BTbricks/modular-bluetooth-receiver/Modular Remote Control Receiver/board/modular-bluetooth-receiver-brd.png

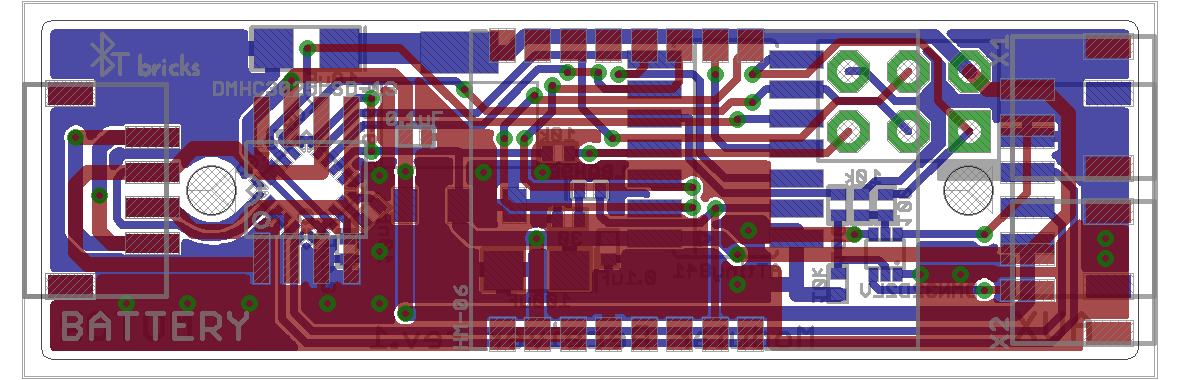
Modular Remote Control Receiver/board/modular-bluetooth-receiver-brd.png
