BTbricks/modular-bluetooth-receiver/Modular Remote Control Receiver/board/modular-bluetooth-receiver-sch.png

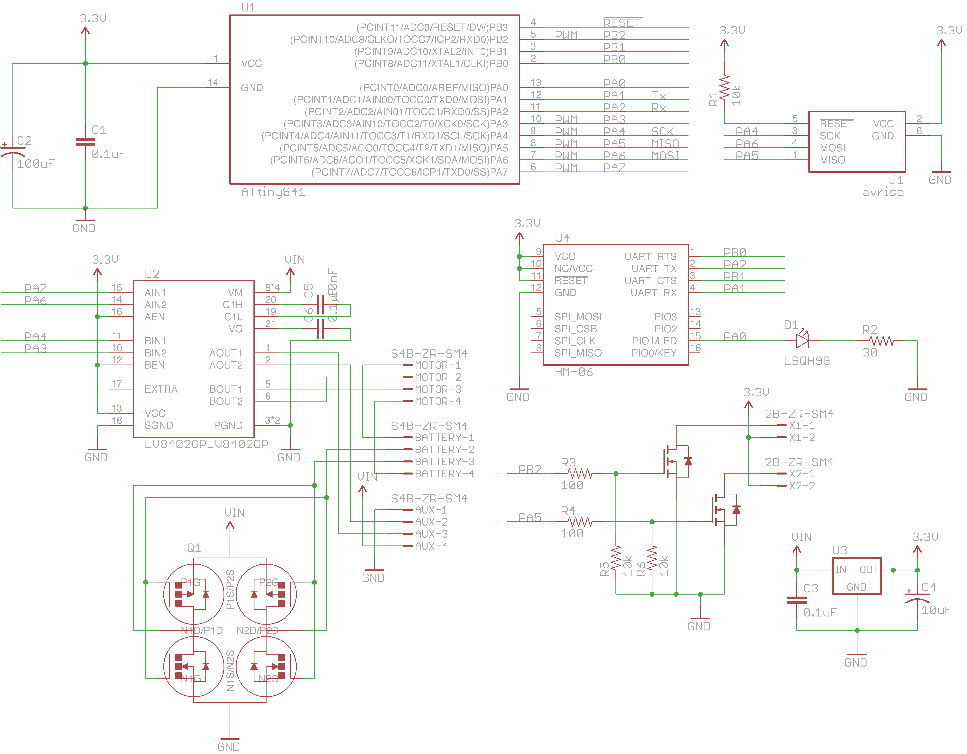
Modular Remote Control Receiver/board/modular-bluetooth-receiver-sch.png
