BTbricks/modular-bluetooth-receiver/Modular Remote Control Receiver/board/Modular Bluetooth Receiver.brd

## EAGLE design Modular Remote Control Receiver/board/Modular Bluetooth Receiver.brd (2015-08-16)

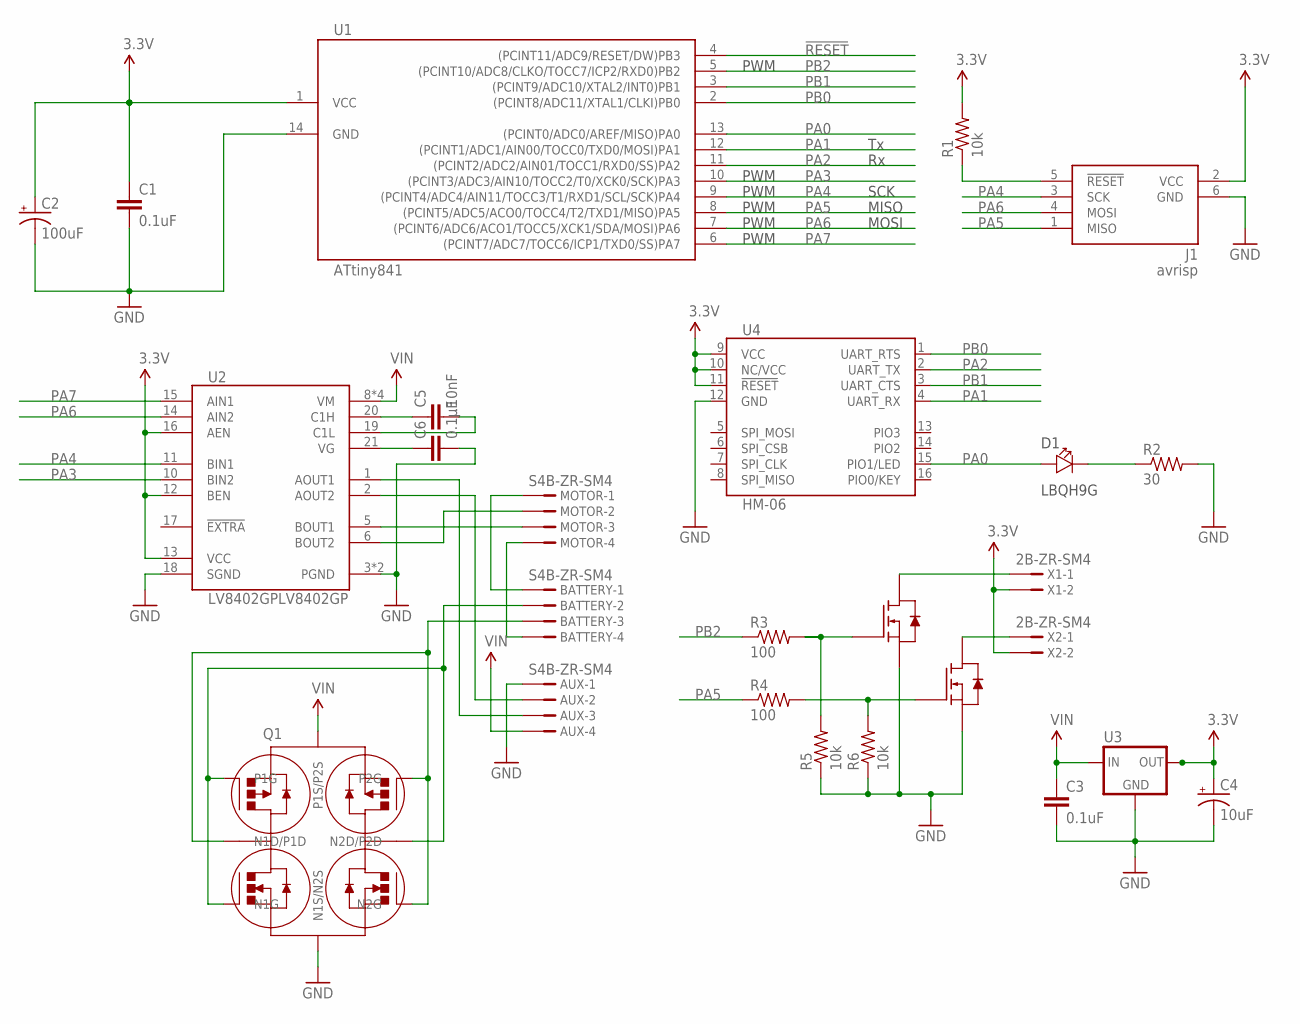
[picture p3: schematic Modular Bluetooth Receiver.sch]

Parts:
AUX: S4B-ZR-SM4
BATTERY: S4B-ZR-SM4
C1: 0.1uF; 0402; PARTNO 0603YC104KAT2A
C2: 100uF; 1206; PARTNO MCTT21X106M6R3CT
C3: 0.1uF; 0402
C4: 10uF; 1206
C5: 10nF; 0402
C6: 0.1µF; 0402
D1: LBQH9G; 0402_POL
J1: avrisp; CON6P2R
MOTOR: S4B-ZR-SM4
Q1: DMHC3025LSD-13; SO8
Q2: DMN32D2LV; SOT-563
R1, R5, R6: 10k; 0402; PARTNO ERJ-3GEYJ103V
R2: 30; 0402
R3, R4: 100; 0402
U1: ATtiny841; 14SOICN
U2: LV8402GPLV8402GP; VCT24
U3: RT9164A; SOT223
U4: HM-06; HM-05/06/07
X1, X2: 2B-ZR-SM4; S2B-ZR-SM4

Connections:
3.3V: C1.1, C2.1 (+), C4.1 (+), J1.2 (VCC), R1.2, U1.1 (VCC), U2.12 (BEN), U2.13 (VCC), U2.16 (AEN), U3.2 (OUT), U3.4 (OUT), U4.9 (VCC), U4.10 (NC/VCC), U4.11 (!RESET), X1.2, X2.2
!RESET: J1.5 (!RESET), R1.1, U1.4 ((PCINT11/ADC9/RESET/DW)PB3)
GND: AUX.1, C1.2, C2.2 (-), C3.2, C4.2 (-), C6.2, J1.6 (GND), Q1.P$3 (N1S/N2S), Q2.P$1 (SOURCE), Q2.P$4 (SOURCE), R2.2, R5.1, R6.1, U1.14 (GND), U2.3 (PGND), U2.4 (PGND), U2.18 (SGND), U3.1 (GND), U4.12 (GND)
unnamed: BATTERY.1, MOTOR.1
unnamed: BATTERY.4, MOTOR.4
unnamed: MOTOR.3, U2.5 (BOUT1)
unnamed: Q2.P$6 (DRAIN), X1.1
unnamed: AUX.3, U2.1 (AOUT1)
unnamed: AUX.2, U2.2 (AOUT2)
unnamed: BATTERY.2, Q1.P$1 (N1G), Q1.P$6 (N2D/P2D), Q1.P$8 (P1G)
unnamed: BATTERY.3, Q1.P$2 (N1D/P1D), Q1.P$4 (N2G), Q1.P$5 (P2G)
unnamed: C5.2, U2.19 (C1L)
unnamed: C6.1, U2.21 (VG)
unnamed: Q2.P$3 (DRAIN), X2.1
unnamed: D1.P$1, R2.1
unnamed: Q2.P$2 (GATE), R3.2, R5.2
unnamed: Q2.P$5 (GATE), R4.2, R6.2
unnamed: C5.1, U2.20 (C1H)
unnamed: MOTOR.2, U2.6 (BOUT2)
PA0: D1.P$2, U1.13 ((PCINT0/ADC0/AREF/MISO)PA0), U4.15 (PIO1/LED)
PA1: U1.12 ((PCINT1/ADC1/AIN00/TOCC0/TXD0/MOSI)PA1), U4.4 (UART_RX)
PA2: U1.11 ((PCINT2/ADC2/AIN01/TOCC1/RXD0/SS)PA2), U4.2 (UART_TX)
PA3: U1.10 ((PCINT3/ADC3/AIN10/TOCC2/T0/XCK0/SCK)PA3), U2.10 (BIN2)
PA4: J1.3 (SCK), U1.9 ((PCINT4/ADC4/AIN11/TOCC3/T1/RXD1/SCL/SC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), U2.11 (BIN1)
PA5: J1.1 (MISO), R4.1, U1.8 ((PCINT5/ADC5/ACO0/TOCC4/T2/TXD1/MISO)PA5)
PA6: J1.4 (MOSI), U1.7 ((PCINT6/ADC6/ACO1/TOCC5/XCK1/SDA/MOSI)P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), U2.14 (AIN2)
PA7: U1.6 ((PCINT7/ADC7/TOCC6/ICP1/TXD0/SS)PA7), U2.15 (AIN1)
PB0: U1.2 ((PCINT8/ADC11/XTAL1/CLKI)PB0), U4.1 (UART_RTS)
PB1: U1.3 ((PCINT9/ADC10/XTAL2/INT0)PB1), U4.3 (UART_CTS)
PB2: R3.1, U1.5 ((PCINT10/ADC8/CLKO/TOCC7/ICP2/RXD0)PB2)
VIN: AUX.4, C3.1, Q1.P$7 (P1S/P2S), U2.8 (VM), U2.9 (VM), U2.22 (VM), U2.23 (VM), U3.3 (IN)

Notes on the sheet:
MOSI
MISO
SCK
PWM

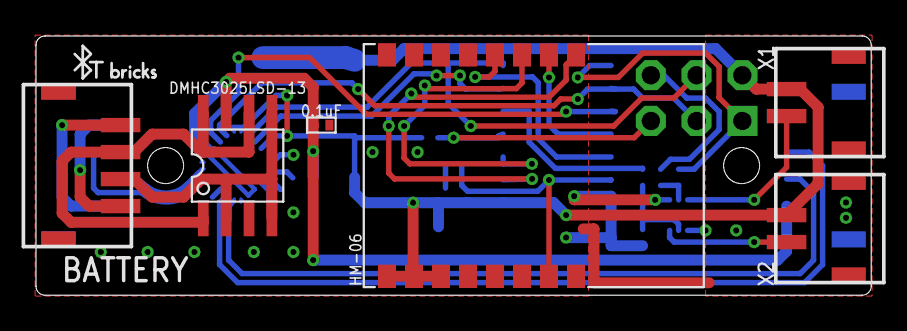
[picture p4: board Modular Bluetooth Receiver.brd from above]

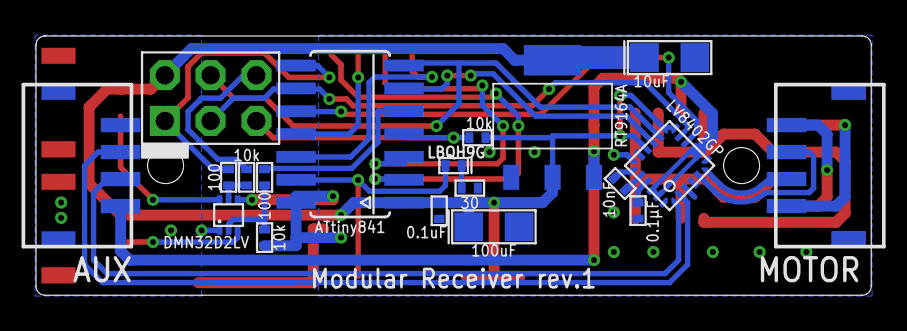
[picture p5: board Modular Bluetooth Receiver.brd from below]

Board: 2 copper layers, 46.4 x 14.4 mm, 25 parts (19 on the bottom side), 31 nets.
